d-mao/trigger-box/README.md

# trigger-box
Hardware documentation for a trigger relay box used in auditory EEG data acquisition

Files:

Documentation - full documentation word doc

trigger_relay.ino - microcontroller code

trigger_demo.m - Matlab code demonstrating how the trigger box works

triggerbox_demo_tester.wav - Sound stimuli used in conjunction with the Matlab code above.

Documentation last updated: 12th Oct 2016

GitHub created: 13th Dec 2018
